tdnieder/PREN2_ET/README.txt

# PREN2_ET
electronic part of the PREN project. Contains frdm kl25z project
