tdnieder/PREN2_ET/Power_Management/Project Outputs for Power_Management/Base/Fab_LPKF/PA_PowerManagement_Base.rtf

Produktionsauftrag: Printfabrikation

Allgemeine Hinweise:

Printgrösse: 80mm x 130mm
Min. Lochdurchmesser: 32 mil
Min. Leiterbahngrösse: 20 mil
Umsetzungsart: durchkontatiert
______________________________________

Auftragsinformationen:

Name: Niederberger
Vorname: Fabian
CC/Fach: PREN2 / Team10
Telefonnummer: 0786970557
Stückzahl 2
______________________________________

Auftragsname: PowerManagement_Base.cam

Datum: 29.4.2016

Visum: ________________________________________
