tdnieder/PREN2_ET/Power_Management/Project Outputs for Power_Management/Driver/Fab_LPKF/PA_PowerManagement_Driver.rtf

Produktionsauftrag: Printfabrikation

Allgemeine Hinweise:

Printgrösse: 37mm x 41mm
Min. Lochdurchmesser: 35 mil
Min. Leiterbahngrösse: 10 mil
Umsetzungsart: durchkontatiert
______________________________________

Auftragsinformationen:

Name: Niederberger
Vorname: Fabian
CC/Fach: PREN2 Team10
Telefonnummer: 0786970557
Stückzahl 2
______________________________________

Auftragsname: PowerManagement_Driver.cam

Datum: 19.4.2016

Visum: ________________________________________
