tdnieder/PREN2_ET/Power_Management/Project Outputs for Power_Management/uC/Fab_LPKF/PA_PowerManagement_uC.rtf

Produktionsauftrag: Printfabrikation

Allgemeine Hinweise:

Printgrösse: 84mm x 107mm
Min. Lochdurchmesser: 35 mil
Min. Leiterbahngrösse: 10 mil
Umsetzungsart: durchkontatiert
______________________________________

Auftragsinformationen:

Name: Niederberger
Vorname: Fabian
CC/Fach: PREN2 / Team 10
Telefonnummer: 0786970557
Stückzahl 2
______________________________________

Auftragsname: PowerManagement_uC.cam

Datum: 19.4.2016

Visum: ________________________________________
