tdnieder/PREN2_ET/H-Bridge_Test/readme.txt

In diesem Ordner befindet sich der PCB für den DRV8835 Treiber.
Dieser PCB wird auf den PowerManagement PCB gesteckt
Das PCB ist soweit fertig.
