tdnieder/PREN2_ET/H-Bridge_Test/Project Outputs for H-Bridge_Test/Fab_LPKF/PA_H_Bridge_Test.rtf

Produktionsauftrag: Printfabrikation

Allgemeine Hinweise:

Printgrösse: 19mm x 17mm
Min. Lochdurchmesser: 39 mil
Min. Leiterbahngrösse: unbekannt
Umsetzungsart: Einseitig
______________________________________

Auftragsinformationen:

Name: Niederberger
Vorname: Fabian
CC/Fach: PREN2
Telefonnummer: 0786970557
Stückzahl 2
______________________________________

Auftragsname: H_Bridge_Test.cam

Datum: 30.3.2016

Visum: ________________________________________
