tdnieder/PREN2_ET/Power_Management/PowerManagement_Base.PDF

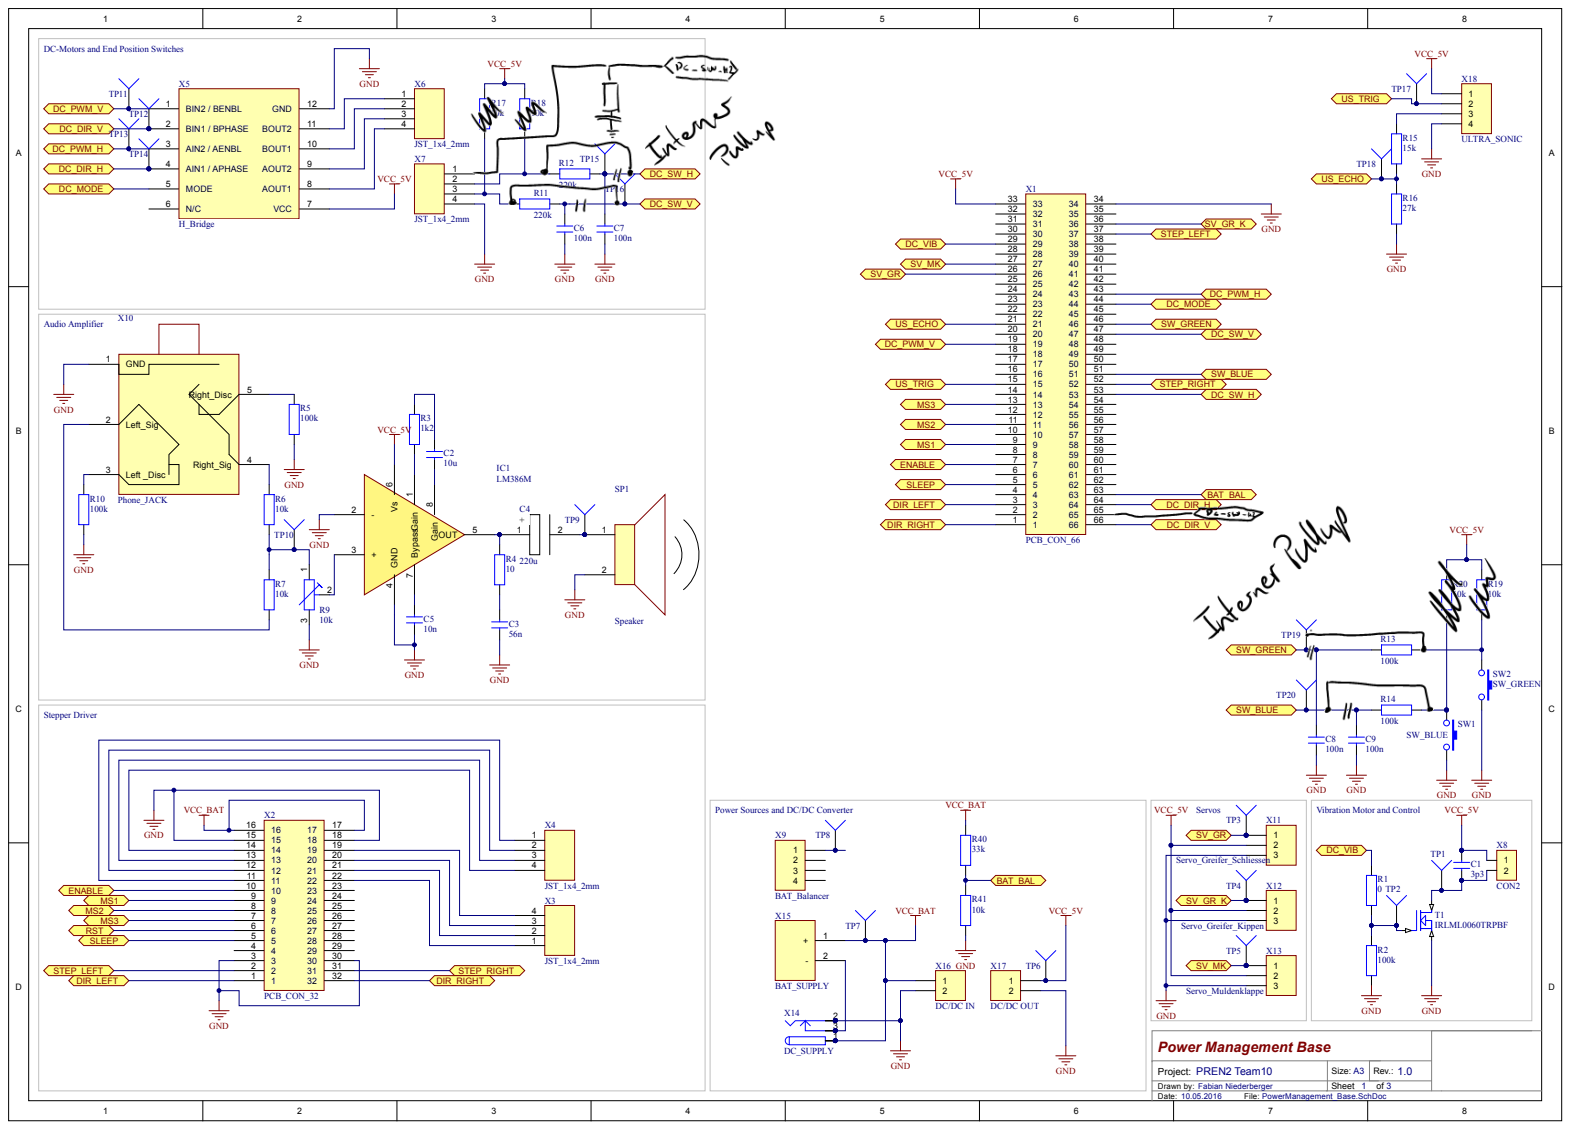
[picture p1: page 1]

DC-Motors and End Position Switches

Stepper Driver

Drawn by: Fabian Niederberger | Sheet 1 of 3
Date: 10.05.2016 File: PowerManagement_Base.SchDoc
