tdnieder/PREN2_ET/Power_Management/PowerManagement_Driver.PDF

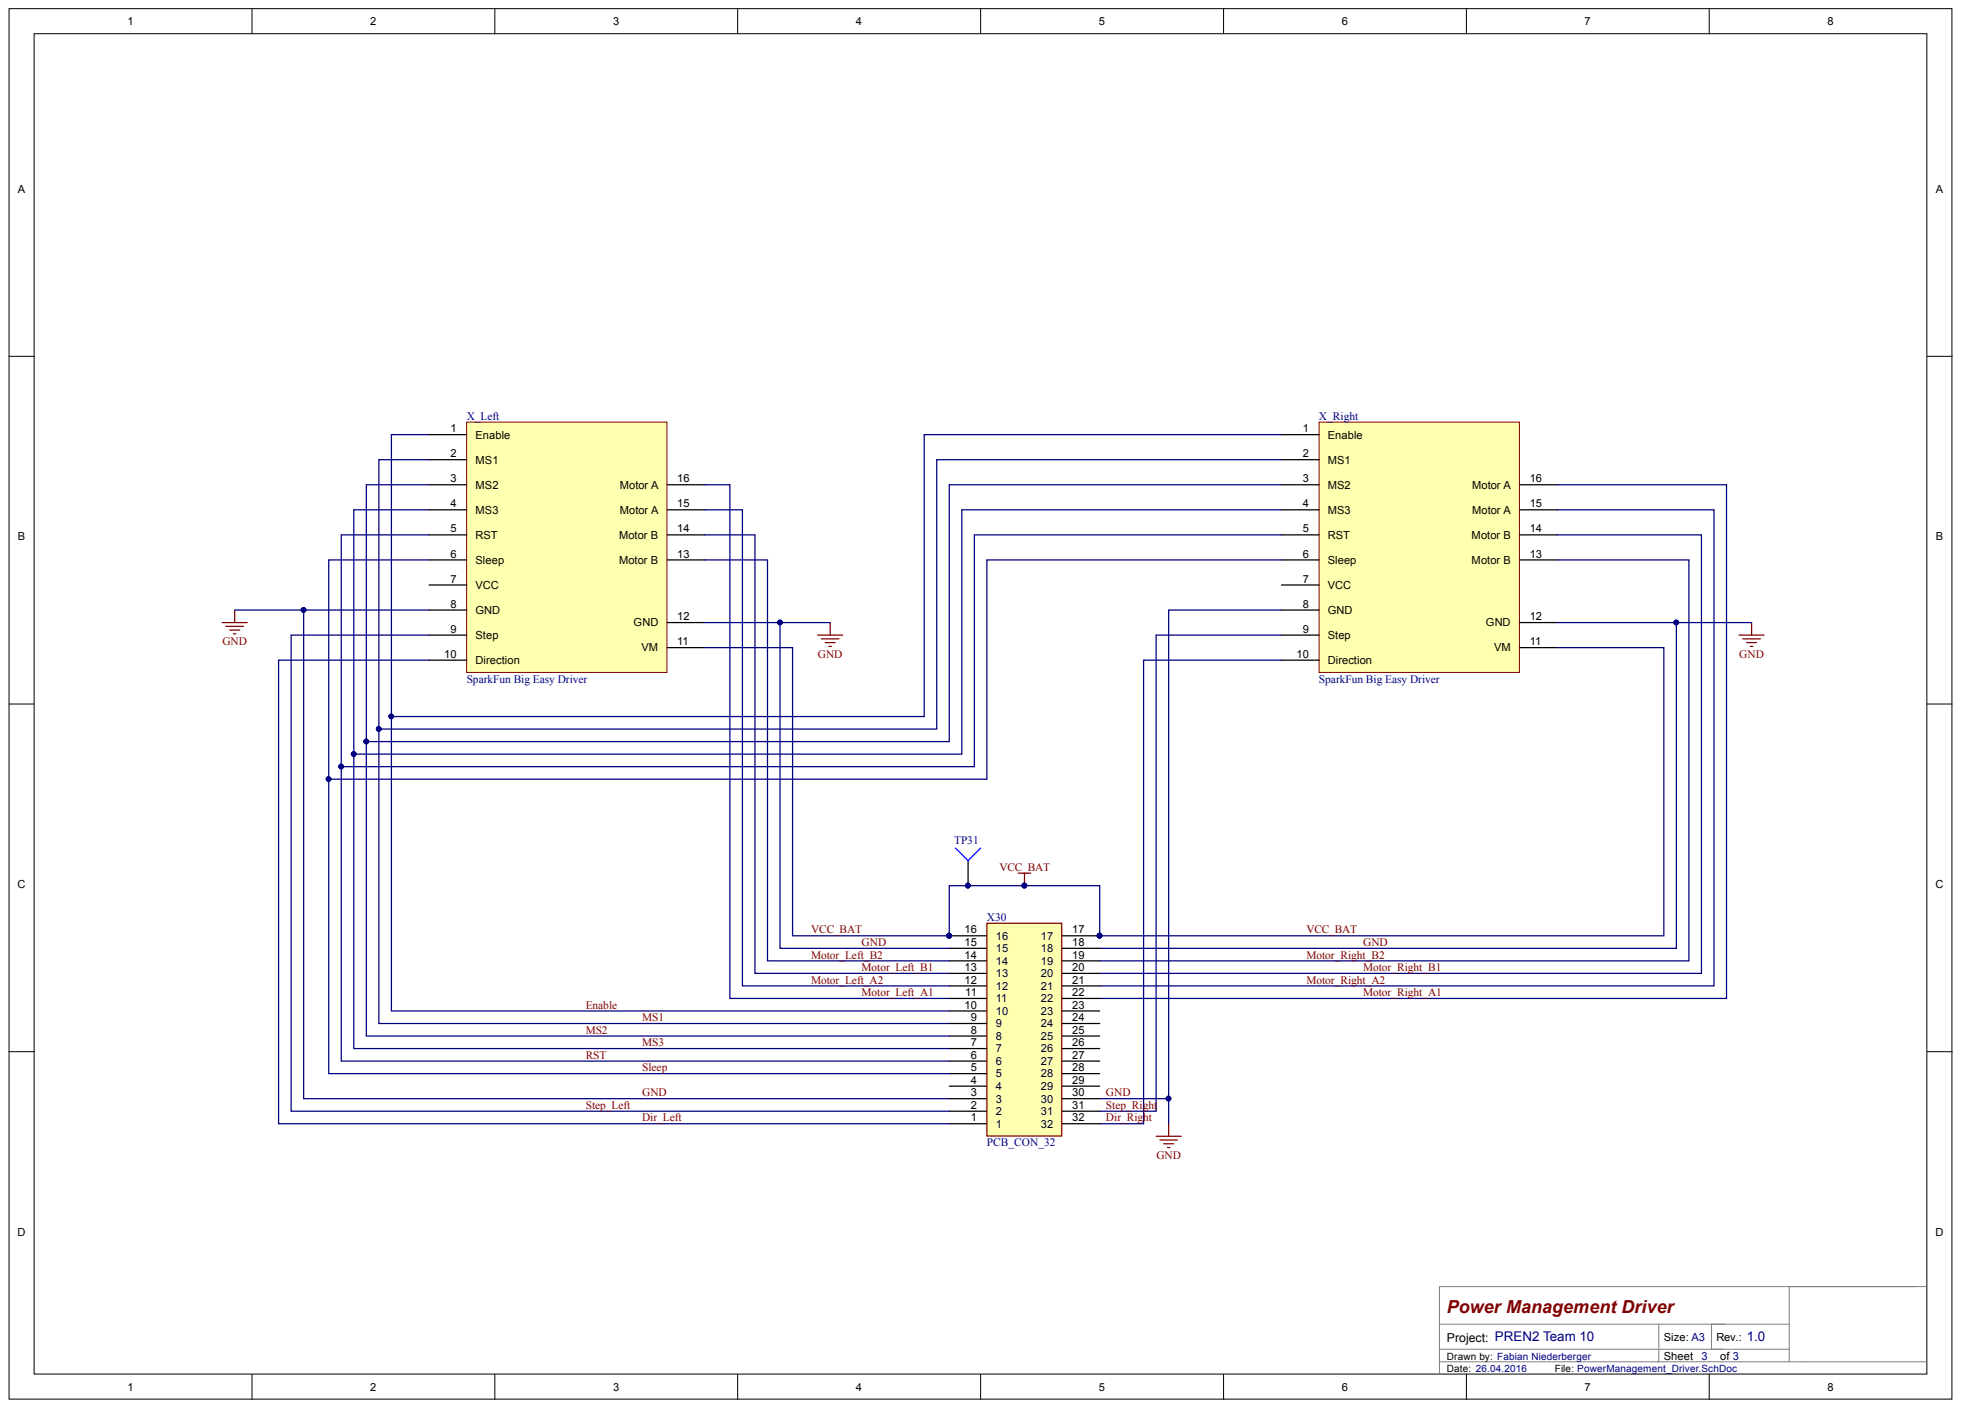
[picture p2: page 1]

MS3 4 Motor A | 15 | | | MS3 4

RST 5 Motor B | 14 | | | | RST 5

Sleep 6 Motor B | 13 | | Sleep 6

VCC 7 GND 8 | | | | VCC 7

GND Step 9 | 12

Step 9

Direction 10 VM

11 | GND

SparkFun Big Easy Driver

Enable | VCC_BAT | TP31

Power Management Driver

Project: PREN2 Team 10 | Size: A3 | Rev.: | 1.0
Drawn by: Fabian Niederberger | Sheet 3 of 3
