tdnieder/PREN2_ET/Power_Management/PowerManagement_uC.PDF

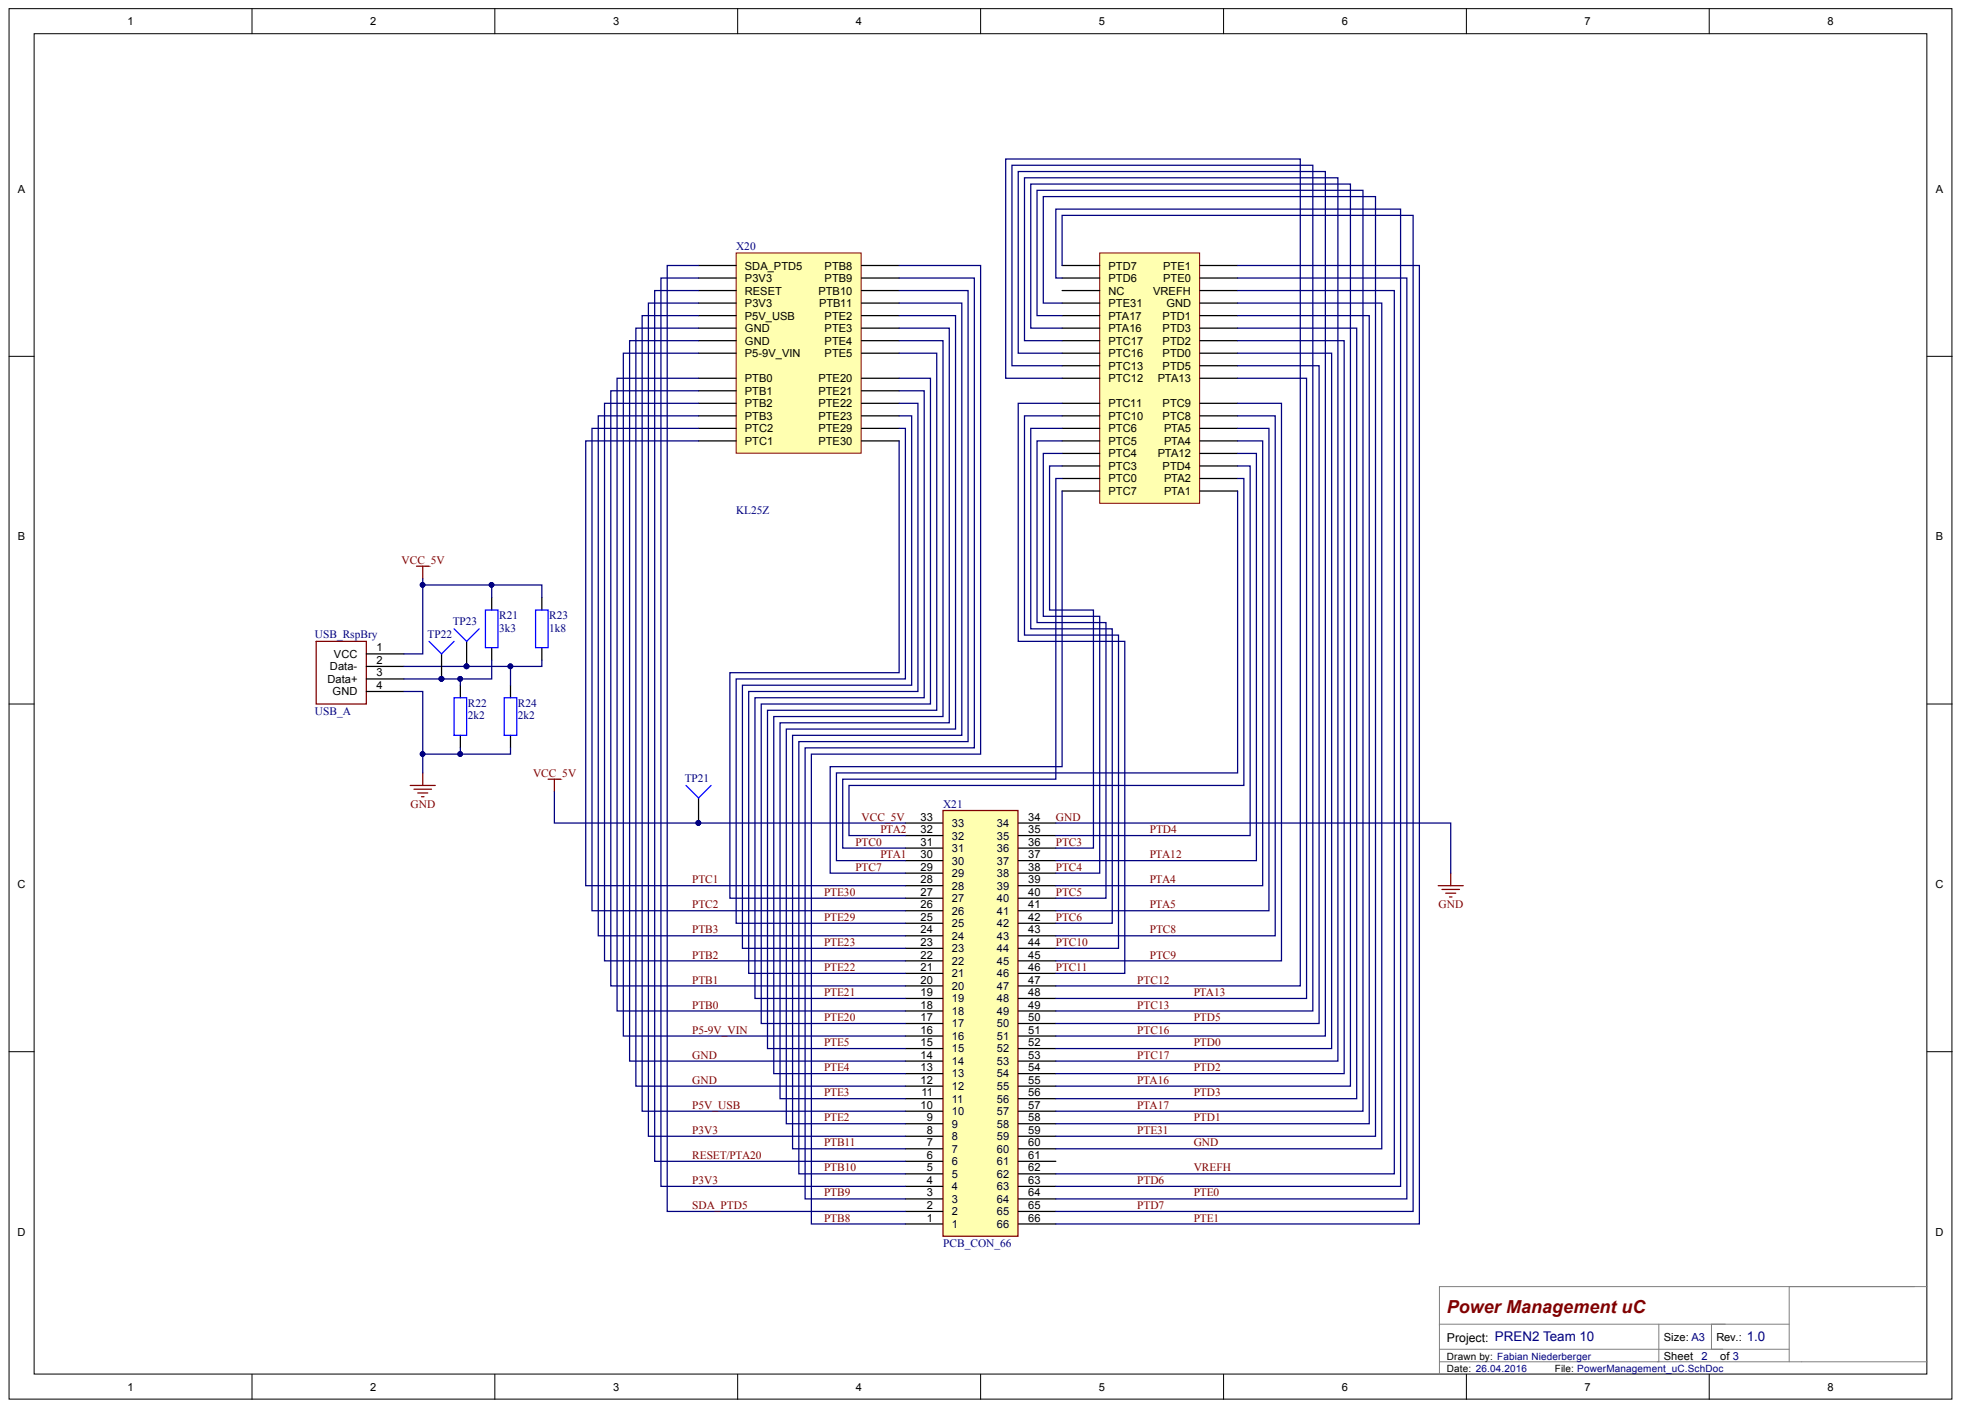
[picture p3: page 1]

PTB1 PTE21 PTB2 PTE22

PTC12 PTA13

PTC3 PTD4
PTC0 PTA2
PTC7 PTA1

Power Management uC

Project: PREN2 Team 10 | Size: A3 | Rev.: | 1.0
Drawn by: Fabian Niederberger | Sheet 2 of 3
