tdnieder/PREN2_ET/Power_Management/Assembly Drawings.pdf

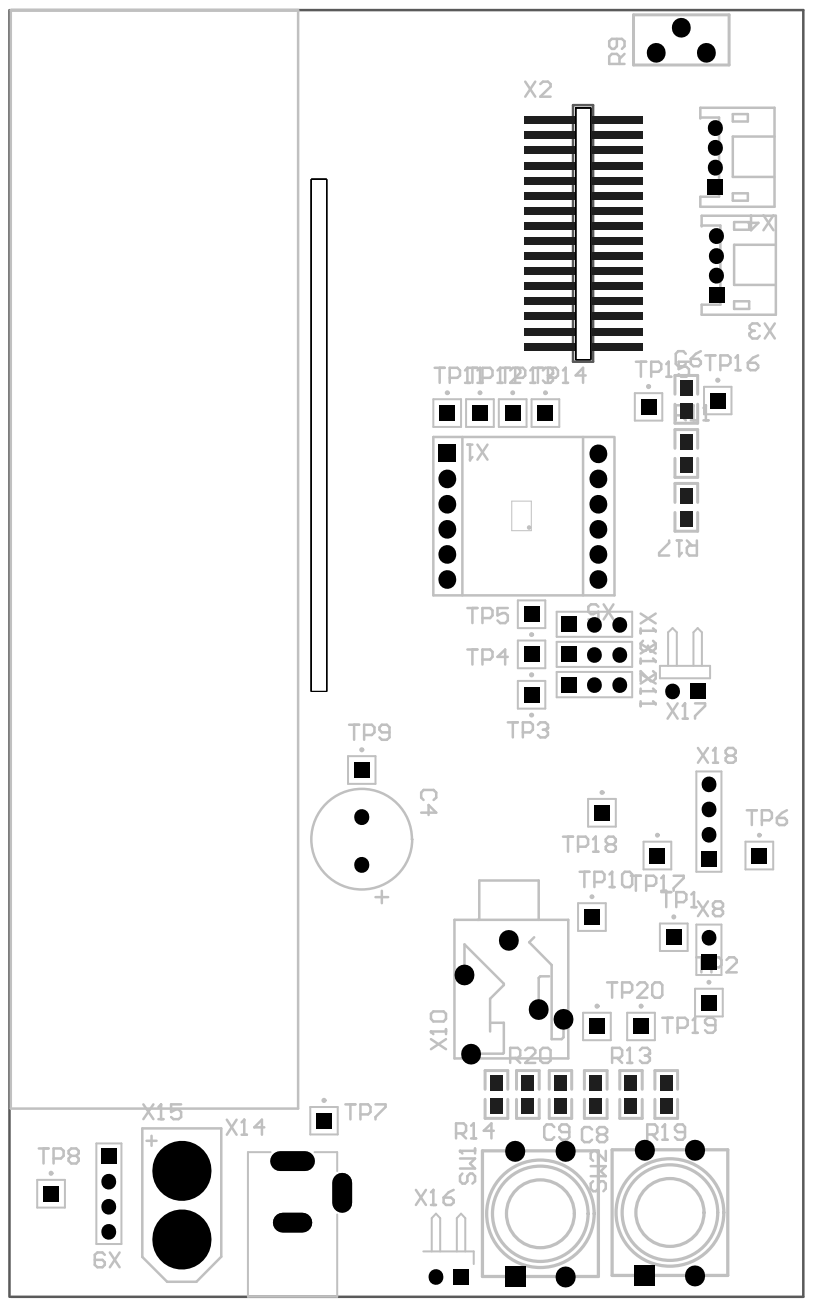
[picture p4: page 1]

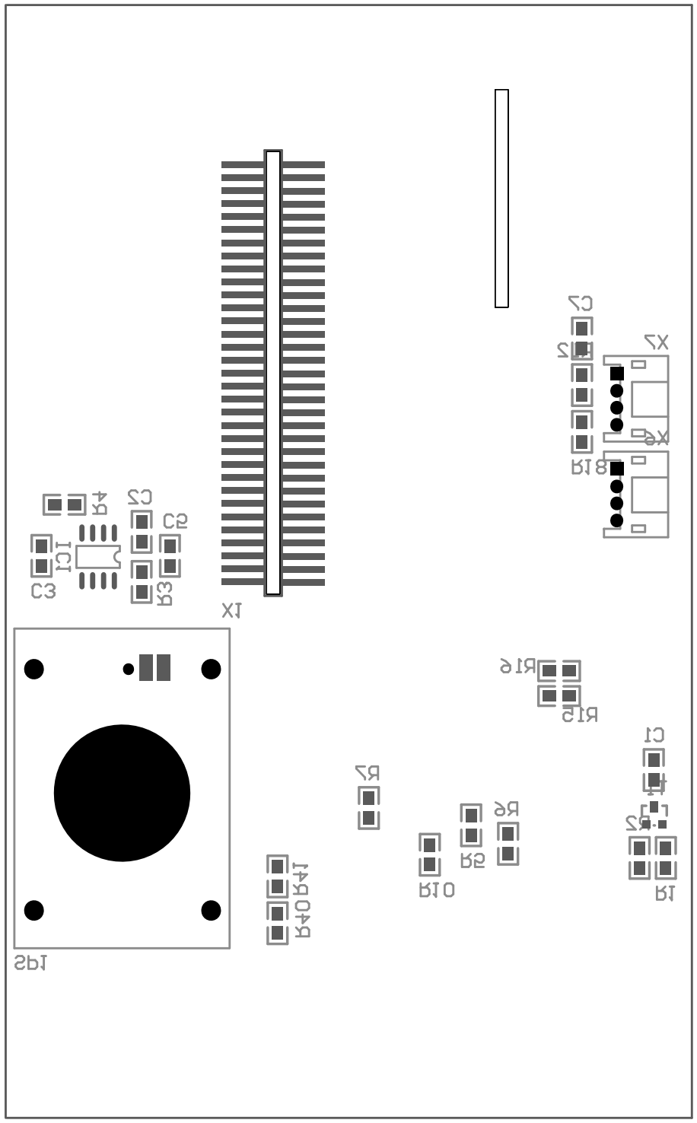
[picture p5: figure]
