tdnieder/PREN2_ET/H-Bridge_Test/H-Bridge_Test.PDF

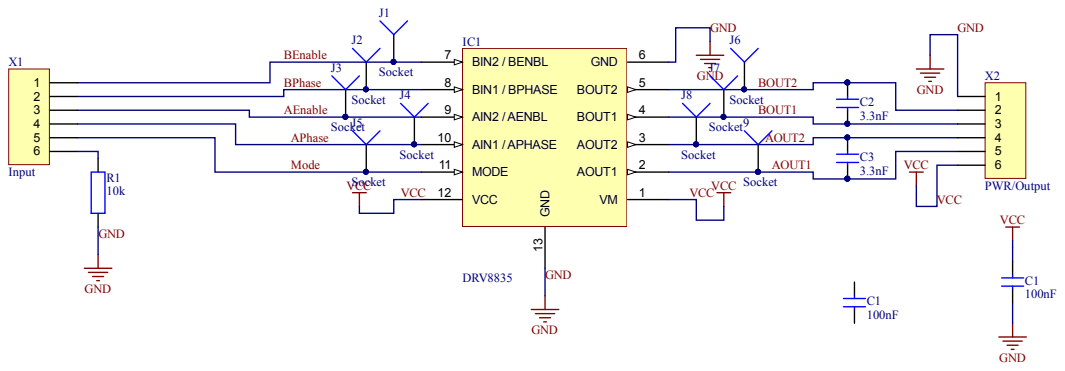
[picture p6: page 1]

P r oject: * | S ize: | Rev | . : *
Drawn by: * | * *
