tdnieder/PREN2_ET/(list of files, drawings)

Other design files:
H-Bridge_Test/DRV8835.SchLib
H-Bridge_Test/H-Bridge_Test.PcbDoc
H-Bridge_Test/H-Bridge_Test.PrjPcb
H-Bridge_Test/H-Bridge_Test.SchDoc
H-Bridge_Test/H-Bridge_Test.SCHLIB
H-Bridge_Test/WSON-12Lib.PcbLib
Power_Management/Power_Management1/FreedomKL25Z.PcbLib
Power_Management/Power_Management1/H-Bridge_Test.PcbLib
Power_Management/Power_Management1/Power_Management.SCHLIB
Power_Management/Power_Management2/FreedomKL25Z.PcbLib
Power_Management/Power_Management2/H-Bridge_Test.PcbLib
Power_Management/Power_Management2/Power_Management.SCHLIB
Power_Management/Power_Management.PrjPcb
Power_Management/PowerManagement.SchDoc
Power_Management/PowerManagement_Base.PcbDoc
Power_Management/PowerManagement_Base.SchDoc
Power_Management/PowerManagement_Base_v2.SchDoc
Power_Management/PowerManagement_Driver.PcbDoc
Power_Management/PowerManagement_Driver.SchDoc
Power_Management/PowerManagement_uC.PcbDoc
Power_Management/PowerManagement_uC.SchDoc
Power_Management/PowerManagement_uC_v2.SchDoc
Power_Management/PREN2Lib.PcbLib
Power_Management/PREN2Lib.SchLib
