tdnieder/PREN2_ET/FRDM_OpenSDA_USBCDC/Sources/Color.h

/*
 * Color.h
 *
 *  Created on: 27.04.2016
 *      Author: Daniel Klauser
 */

#ifndef SOURCES_COLOR_H_
#define SOURCES_COLOR_H_

/*
 * Bekommt die Farbe vom Startknopf
 */
int buttonPressed();

#endif /* SOURCES_COLOR_H_ */
