tdnieder/PREN2_ET/FRDM_OpenSDA_USBCDC/Sources/interface.h

/*
 * interface.h
 *
 *  Created on: 02.03.2016
 *      Author: danie
 */



#ifndef SOURCES_INTERFACE_H_
#define SOURCES_INTERFACE_H_

typedef enum {
  TIMER_IDLE,
  TIMER_USED
} Timer;

typedef struct {
Timer Timer0;
Timer Timer1;
Timer Timer2;
} TimerState;

volatile TimerState Status;

void CDC_Run(void);

void cutString(char*);

void switchCase(char*);

void shitDown(void);

#endif /* SOURCES_INTERFACE_H_ */
