tdnieder/PREN2_ET/(commit log)

2016-02-23 Open SDA and USB CDC Test Program
    With this program the OpenSDA USB interface is used for programing and
    debugging. The leftover KL25Z USB programing interface is modified to a
    serial port (USB CDC, appears as COM-port on device manager)
    The external clock on the board is used and modified to 48MHz
    The program echos everything you send it, for example:
    -> send: "Hello Freedom Board"
    -> receive: "echo: Hello Freedom Board"
    credits to Erich Styger and his MCUonEclipse Blog
    http://mcuoneclipse.com/2012/10/07/tutorial-usb-cdc-with-the-kl25z-freedom-board/
2016-02-26 Added Pin Assignment Document
    [FRDM KL25Z Pin besetzung.xlsx]
2016-02-29 update pin besetzung
    alle timer relevanten pins sind zugeteilt, noch keine GPIO!!!
    [FRDM KL25Z Pin besetzung.xlsx]
2016-03-01 +Engine.h/c
    Motor links und rechts wurden hinzugefügt.
2016-03-01 Erweiterung Engine
    Counter variabel hinzugefügt hinzugefügt bei engine
    Switch Case bei main
2016-03-02 interface.c/h
    CDC von der main ausgegliedert und in eine neues c und h file
    exportiert.
    Neue funktionen inmplementiert
2016-03-04 Added Power_Management PCB-Project
    Lades s pcb aber noni ufe well projekt mehrheitlech us möll-dateie
    bestohd. Muess das no bereinige. Lade denn nor die wechtige Files ufe
2016-03-07 Ultrasonic removed
2016-03-07 Endlich mit Ultrasonic!!!!!!!
2016-03-08 Enum,Servos
    Enum bei Engines hinzugefügt als Status.
    Diverse Funktionen bei Enigines hinzugefügt.
    Servos als Component hinzugefügt.
    [FRDM KL25Z Pin besetzung.xlsx]
2016-03-10 removing H-Bridge_Test PCB project from repository
    Not essential, no need for sharing until finished verison 1.0
2016-03-14 Engine Timer sollte nun gehen
    Zugriff auf C1 und C0 Value von Timer zwei implementiert + gewütet.
2016-03-17 bereit zumtesten
    igjgjg
    [FRDM KL25Z Pin besetzung.xlsx]
2016-03-27 Pins hinzugefügt
    [FRDM KL25Z Pin besetzung.xlsx]
2016-03-27 pin added
    [FRDM KL25Z Pin besetzung.xlsx]
2016-03-27 motor_links
    ergänzung
    [FRDM KL25Z Pin besetzung.xlsx]
2016-03-31 Ready
    Bereit für ersten Testlauf
    Ultraschall - check
    Engine - check
    Greifer - check/2
    mulde - check
    [FRDM KL25Z Pin besetzung.xlsx]
2016-03-31 H-Bridge Test PCB hinzugefügt
    Das fertige PCB für die H-Bridge ist ab jetzt verfügbar. Es kann nun in
    bestehende Projekt als Library eingebunden werden. Somit kann es als
    Shield verwendet werden.
    [DRV8835.SchLib, H-Bridge_Test.PcbDoc, H-Bridge_Test.PrjPcb, H-Bridge_Test.SCHLIB, H-Bridge_Test.SchDoc, WSON-12Lib.PcbLib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]
2016-04-01 Anpassen des gitignres
    Die Documentation files des Altium braucht man nicht zu committen
    [DRV8835.SchLib]
2016-04-06 added Power Management PCB to repository
    DO NOT CHANGE ANYTHING on Altium Project if you don't know what you are
    doing. I have putten now more than 20h of work into the Power Management
    PCB project to get it right this time.
    I have drawn the first parts an created the structure of the project.
    Everything is now on the best way to get the max. out of what I have in
    mind.
    [DRV8835.SchLib, FreedomKL25Z.PcbLib, H-Bridge_Test.PcbDoc, H-Bridge_Test.PcbLib, H-Bridge_Test.SchDoc, PREN2Lib.PcbLib, PREN2Lib.SchLib, PowerManagement.SchDoc]
2016-04-07 improving h-bridge, additional stuff for pwrmanagment pcb
    [H-Bridge_Test.PcbDoc]
2016-04-07 Ultraschall gefict
    [FRDM KL25Z Pin besetzung.xlsx]
2016-04-09 Teils fertig
    Ultraschall - ok
    Engine - ok
    Greifer Servos - ok
    Greifer DC - nok
    mulde servo - ok
    Accel - nok
    Endschalter - nok
2016-04-10 Alle Komponenten gezeichnet
    Es sind nun alle Komponenten gezeichnet und in der Projektlibrary
    verfügbar. Die Komponenten die Fehlen sind etweder in den HSLU Librarys
    oder in den Miscellaneous Libs drin.
    !!!!!VORSICHT: PROJEKT FUNKTIONIERT EVTL NICHT MEHR WENN ES AUF EINEM
    ANDEREN PC GEÖFFNET WIRD. DAS VERHÄLT SICH NICHT WIE PROGRAMMIERTER
    CODE.
    [PREN2Lib.PcbLib, PREN2Lib.SchLib, PowerManagement_Base.SchDoc]
2016-04-11 änderungen am Speaker.
    Ich bin mir nicht sicher ob bei der Herstellung der Drill_Drawing Layer
    berücksichtigt wird, deshalb habe ich die Bohrungen zu Pads ohne Rand
    geändert
    [PREN2Lib.PcbLib, PREN2Lib.SchLib]
2016-04-12 Schema uC PCB gezeichnet
    [PowerManagement_Base.SchDoc, PowerManagement_uC.SchDoc]
2016-04-12 Contributions to existing Libraries, and Schematics, new Schematics
    -Big Easy Driver fehlte noch als Komponente
    -Aufgrund von inkompatibilität musste der min USB B auf USB A geändert
    werden
    -Modifikationen am uC Board
    -Schema Driver gezeichnet
    [PREN2Lib.PcbLib, PREN2Lib.SchLib, PowerManagement_Base.SchDoc, PowerManagement_Driver.SchDoc, PowerManagement_uC.SchDoc]
2016-04-13 AB JETZT KEINE PIN ÄNDERUNGEN MEHR!!!
    2/3 der Schemas sind gezeichnet
    [PowerManagement_Base.SchDoc, PowerManagement_uC.SchDoc, Power_Management.PrjPcb]
2016-04-13 Schema 95%
    Nur noch kleine Änderungen und Verbesserungen nach Besprechung im Plenum
    [FRDM KL25Z Pin besetzung.xlsx, PREN2Lib.SchLib, PowerManagement_Base.SchDoc, PowerManagement_Driver.SchDoc, PowerManagement_uC.SchDoc, Power_Management.PrjPcb]
2016-04-13 Pin Besetzung NICHT modifiziert, nur um eine Spalte erweitert
    [FRDM KL25Z Pin besetzung.xlsx]
2016-04-13 ready for SCRUM presentation :)
    Schema ist nun bereit zum besprechen und den Segen des Teams zu
    empfangen fürs Layouten des PCBs
    [PowerManagement_Base.SchDoc, PowerManagement_Driver.SchDoc, PowerManagement_uC.SchDoc]
2016-04-15 pins aktualisiert
    Pin besetzung aktualisiert und änderungem am schema gemäss pin besetzung
    [FRDM KL25Z Pin besetzung.xlsx, PowerManagement_Base.SchDoc, Power_Management.PrjPcb]
2016-04-16 PCBs erstellt, uC fertig gelayoutet
    [PREN2Lib.PcbLib, PowerManagement_Base.PcbDoc, PowerManagement_Base.SchDoc, PowerManagement_Driver.PcbDoc, PowerManagement_Driver.SchDoc, PowerManagement_uC.PcbDoc, PowerManagement_uC.SchDoc, Power_Management.PrjPcb]
2016-04-16 rebuilt polygons on uC PCB
    [PowerManagement_Driver.PcbDoc, PowerManagement_uC.PcbDoc]
2016-04-16 changing usb from top to bottom side
    [PowerManagement_uC.PcbDoc]
2016-04-16 Minor changes on schematics to improve simplicity of pcb. Driver PCB routed
    [PREN2Lib.PcbLib, PowerManagement_Base.SchDoc, PowerManagement_Driver.PcbDoc, PowerManagement_Driver.SchDoc, PowerManagement_uC.PcbDoc, Power_Management.PrjPcb]
2016-04-18 Driver PCB fertig
    Driver PCB fertig mit 30mil Leiterbahnen für 1A Lasten
    [PowerManagement_Base.SchDoc, PowerManagement_Driver.PcbDoc, PowerManagement_uC.PcbDoc]
2016-04-19 produktionsdateien für produktion erstellt
    [PowerManagement_Base.SchDoc, PowerManagement_Driver.PcbDoc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]
2016-04-21 Controll struktur
    Mit enum und Struct wird geprüft wann welcher Timer aktiv ist. Es soll
    nur ein Channel zur gleichen Zeit aktiv sein!
2016-04-22 H-Bridge Test PDF
    [PREN2Lib.PcbLib, PowerManagement_Base.SchDoc, PowerManagement_Driver.SchDoc, Power_Management.PrjPcb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]
2016-04-22 works
    greifer,und antrieb
2016-04-27 Switch Green/Blue
    Implementiert
2016-05-06 Greifersteuerung/Switch implementiert
    Die Greifersteuerung wird jetzt Automatisch zurückgesetzt und der
    Container wird abgesetzt. Danach fährt der greifer in Ausgangslage.
    Die Schalter für die Farben sind auch implementiert.
2016-05-12 update of pcb and assembly files
    [PREN2Lib.PcbLib, PREN2Lib.SchLib, PowerManagement_Base.PcbDoc, PowerManagement_Base.SchDoc, PowerManagement_Driver.PcbDoc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]
2016-05-13 Taster
    Stecke
    [FRDM KL25Z Pin besetzung.xlsx]
2016-05-14 Distanzmesser + Greifer360
    gefahrene Distanz + Drehen des greifers ist jetzt fertig implementiert.
2016-05-19 pin belegung vervollständigt
    [FRDM KL25Z Pin besetzung.xlsx]
2016-05-19 schema und pin update
    [FRDM KL25Z Pin besetzung.xlsx]
2016-05-22 An und Abschalten
2016-05-22 schema update, v2 mit allen neuerungen in altium
    [PowerManagement_Base_v2.SchDoc, PowerManagement_uC.PcbDoc, PowerManagement_uC.SchDoc, PowerManagement_uC_v2.SchDoc, Power_Management.PrjPcb]
